IsaacNorris/p3-u3-w-hardware/p3-u3-w/p3-u3-w.csv

Reference | Qty | Value | DNP | Exclude from BOM | Exclude from Board | Footprint | Datasheet
C1,C2,C3,C5,C7,C9,C10,C12,C13,C14,C29,C32,C34,C35 | 14 | 100nF |  |  |  | Capacitor_SMD:C_0402_1005Metric
C4,C11,C33,C37,C38 | 5 | 4.7uF |  |  |  | Capacitor_SMD:C_0402_1005Metric
C6,C16,C36 | 3 | 1uF |  |  |  | Capacitor_SMD:C_0402_1005Metric
C8 | 1 | 100pF |  |  |  | Capacitor_SMD:C_0402_1005Metric
C15,C17,C26 | 3 | 2.2uF |  |  |  | Capacitor_SMD:C_0402_1005Metric
C18,C22,C25,C28 | 4 | 0.1uF |  |  |  | Capacitor_SMD:C_0402_1005Metric
C19,C21 | 2 | 2.2nF |  |  |  | Capacitor_SMD:C_0402_1005Metric
C20,C23,C24,C27,C39 | 5 | 10uF |  |  |  | Capacitor_SMD:C_0402_1005Metric
C30,C31 | 2 | 10pF |  |  |  | Capacitor_SMD:C_0402_1005Metric
C40 | 1 | 22uF |  |  |  | Capacitor_SMD:C_0402_1005Metric
C41 | 1 | 0.8pF |  |  |  | Capacitor_SMD:C_0402_1005Metric
C42 | 1 | 0.3pF |  |  |  | Capacitor_SMD:C_0402_1005Metric
CR1 | 1 | USBLC6-2SC6 |  |  |  | Package_TO_SOT_SMD:SOT-23-6 | https://www.st.com/resource/en/datasheet/usblc6-2.pdf
D1 | 1 | LED PWR Indicator |  |  |  | Diode_SMD:D_0603_1608Metric
J1 | 1 | SWD_pin |  |  |  | Connector_PinHeader_1.00mm:PinHeader_1x04_P1.00mm_Vertical
J2 | 1 | Display |  |  |  | Connector_PinHeader_2.54mm:PinHeader_1x04_P2.54mm_Vertical
J3 | 1 | SJ-3524-SMT |  |  |  | SJ_3524_SMT_TR:CUI_SJ-3524-SMT
J4 | 1 | 473092651 |  |  |  | 473092651:CONN12_47309-2651_MOL | https://www.molex.com/en-us/products/part-detail-pdf/473092651?display=pdf
J6 | 1 | 12401826E412A |  |  |  | 12401826E412A:12401826_AMP | 12401826E412A
J7 | 1 | Bat Conn |  |  |  | Connector_PinHeader_2.54mm:PinHeader_1x02_P2.54mm_Vertical
J8 | 1 | CONMHF1-SMD-G-T |  |  |  | CONMHF1-SMD-G-T:COAX3_CONMHF1-SMD-G-T_TEC | https://www.te.com/commerce/DocumentDelivery/DDEController?Action=srchrtrv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
L1 | 1 | 0.47uH |  |  |  | Inductor_SMD:L_0603_1608Metric
L2 | 1 | 2.7nH |  |  |  | Inductor_SMD:L_0603_1608Metric
L3 | 1 | 10uH |  |  |  | Inductor_SMD:L_0603_1608Metric
L4 | 1 | 10nH |  |  |  | Inductor_SMD:L_0603_1608Metric
R1 | 1 | 1k |  |  |  | Resistor_SMD:R_0402_1005Metric
R2,R3,R4,R11,R12,R13,R14,R15,R17,R18,R19,R20,R21 | 13 | 10k |  |  |  | Resistor_SMD:R_0402_1005Metric
R5,R6 | 2 | 470R |  |  |  | Resistor_SMD:R_0402_1005Metric
R7,R8,R9,R10 | 4 | 22R |  |  |  | Resistor_SMD:R_0402_1005Metric
R16,R28,R29 | 3 | 100k |  |  |  | Resistor_SMD:R_0402_1005Metric
R22,R23 | 2 | 5k1 |  |  |  | Resistor_SMD:R_0402_1005Metric
R24,R25 | 2 | 2k |  |  |  | Resistor_SMD:R_0402_1005Metric
R26,R27 | 2 | 220K |  |  |  | Resistor_SMD:R_0402_1005Metric
R30 | 1 | 560k |  |  |  | Resistor_SMD:R_0402_1005Metric
SW1,SW2,SW3,SW4,SW5,SW6,SW7 | 7 | SW_SPST |  |  |  | Button_Switch_SMD:Panasonic_EVQPUL_EVQPUC
TP1 | 1 | 5V |  |  |  | TestPoint:TestPoint_Pad_D1.0mm
TP2 | 1 | 3v3 |  |  |  | TestPoint:TestPoint_Pad_D1.0mm
U1 | 1 | LSM6DSM |  |  |  | Package_LGA:LGA-14_3x2.5mm_P0.5mm_LayoutBorder3x4y | https://www.st.com/resource/en/datasheet/lsm6dsm.pdf
U2 | 1 | PCM5102A |  |  |  | Package_SO:TSSOP-20_4.4x6.5mm_P0.65mm | https://www.ti.com/lit/ds/symlink/pcm5102a.pdf
U3 | 1 | STM32WB55CEUx |  |  |  | Package_DFN_QFN:QFN-48-1EP_7x7mm_P0.5mm_EP5.6x5.6mm | https://www.st.com/resource/en/datasheet/stm32wb55ce.pdf
U4 | 1 | LD39050PU33R |  |  |  | LD39050PU33R:DFN6_3X3_STM | https://www.st.com/resource/en/datasheet/ld39050.pdf
U5 | 1 | TPS63802DLAR |  |  |  | TPS63802DLAR:DLA0010A | https://www.ti.com/lit/gpn/tps63802
U6 | 1 | MCP73831T-2ACI/OT |  |  |  | MCP73831T_2ACI_OT:SOT-23-5_MC_MCH | MCP73831T-2ACI/OT
U7 | 1 | DLF162500LT-5028A1 |  |  |  | DLF162500LT:DLF-4_1P6X0P8 | DLF162500LT-5028A1
X1 | 1 | NX2016SA-32MHZ-EXS00A-CS06654 |  |  |  | NX2016SA-32MHZ-EXS00A-CS06654:NX2016SA_NDK | NX2016SA-32MHZ-EXS00A-CS06654
Y2 | 1 | 32k768 |  |  |  | Crystal:Crystal_SMD_3215-2Pin_3.2x1.5mm
