IsaacNorris/p3-u3-w-hardware/p3-u3-w/p3-u3-w.kicad_pcb

## KiCad design p3-u3-w/p3-u3-w.kicad_pcb (2026-11-10)

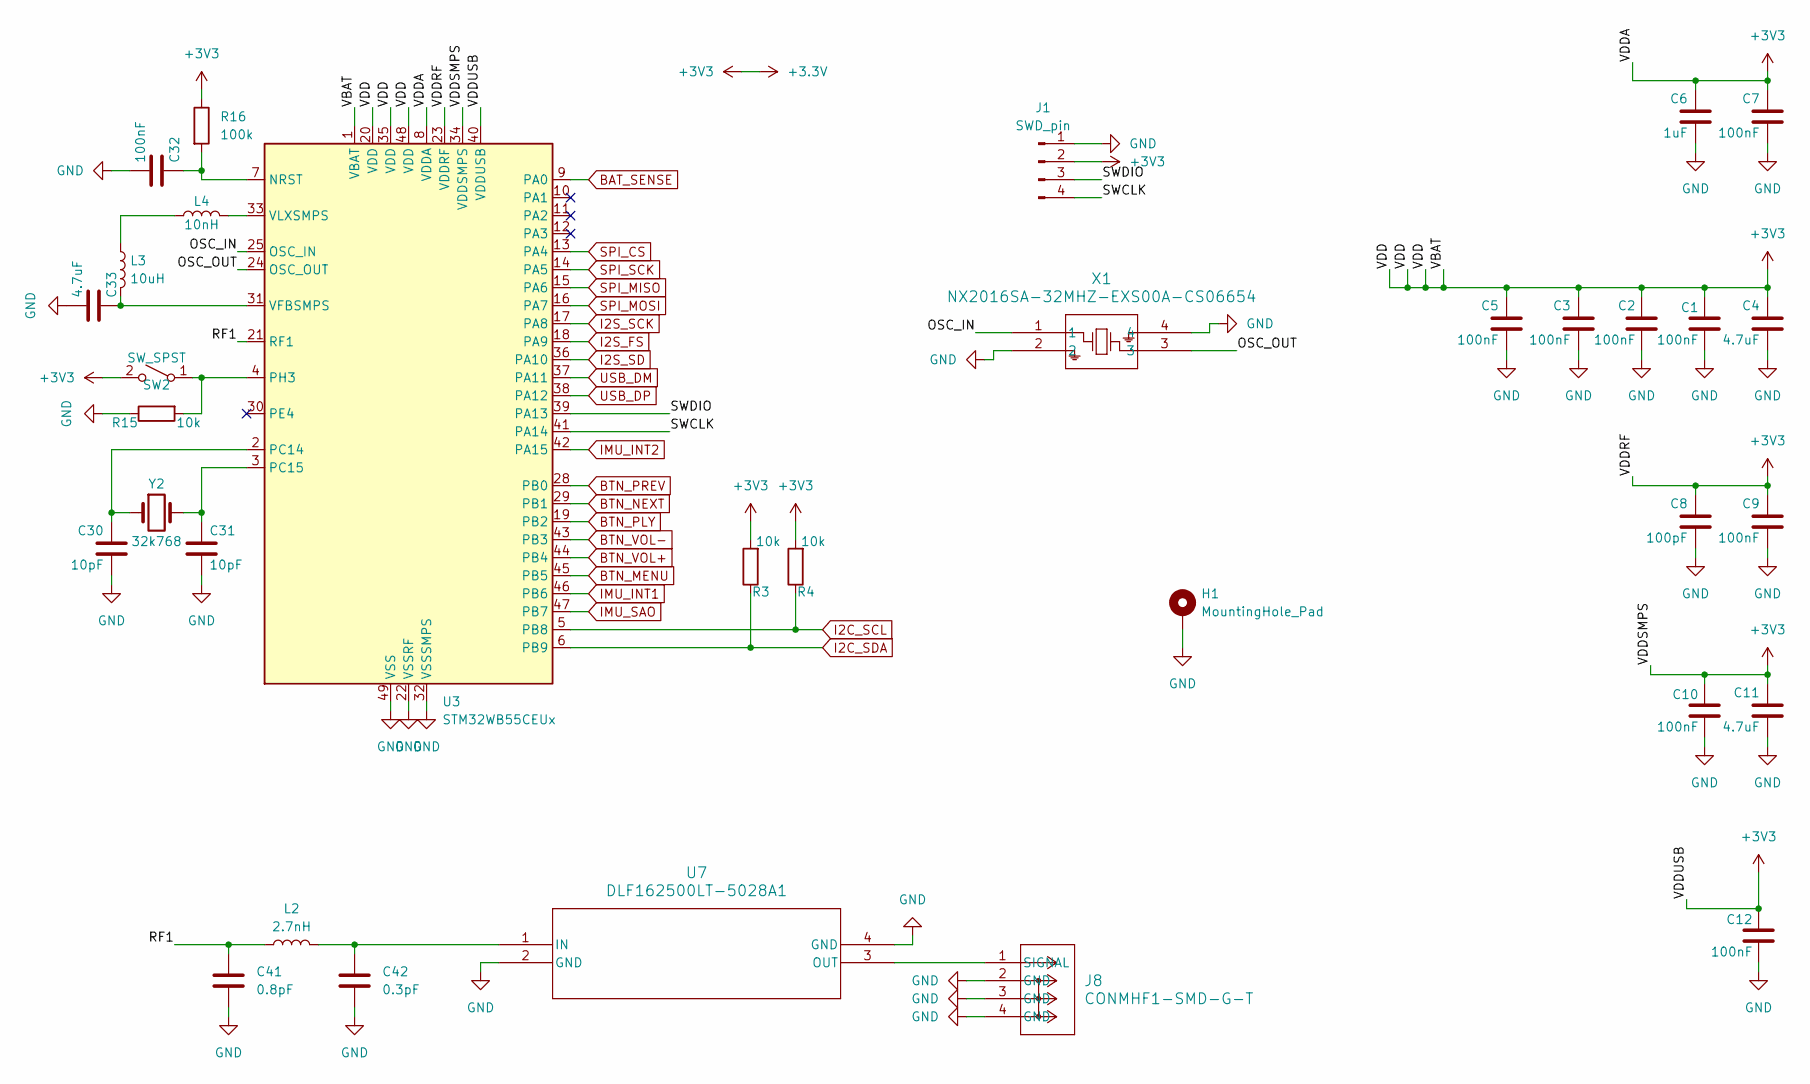
[picture p1: schematic MCU.kicad_sch]

Parts:
C1, C2, C3, C5, C7, C9, C10, C12, C32: 100nF; C_0402_1005Metric
C4, C11, C33: 4.7uF; C_0402_1005Metric
C6: 1uF; C_0402_1005Metric
C8: 100pF; C_0402_1005Metric
C30, C31: 10pF; C_0402_1005Metric
C41: 0.8pF; C_0402_1005Metric
C42: 0.3pF; C_0402_1005Metric
H1: MountingHole_Pad; MountingHole_2.2mm_M2_Pad
J1: SWD_pin; PinHeader_1x04_P1.00mm_Vertical
J8: CONMHF1-SMD-G-T; COAX3_CONMHF1-SMD-G-T_TEC
L2: 2.7nH; L_0603_1608Metric
L3: 10uH; L_0603_1608Metric
L4: 10nH; L_0603_1608Metric
R3, R4, R15: 10k; R_0402_1005Metric
R16: 100k; R_0402_1005Metric
SW2: SW_SPST; Panasonic_EVQPUL_EVQPUC
U3: STM32WB55CEUx; QFN-48-1EP_7x7mm_P0.5mm_EP5.6x5.6mm
U7: DLF162500LT-5028A1; DLF-4_1P6X0P8
X1: NX2016SA-32MHZ-EXS00A-CS06654; NX2016SA_NDK
Y2: 32k768; Crystal_SMD_3215-2Pin_3.2x1.5mm

Connections:
+3.3V: C1.2, C2.2, C3.2, C4.2, C5.2, C6.2, C7.2, C8.2, C9.2, C10.2, C11.2, C12.2, J1.2, R3.2, R4.2, R16.1, SW2.2 (B), U3.1 (VBAT), U3.8 (VDDA), U3.20 (VDD), U3.23 (VDDRF), U3.34 (VDDSMPS), U3.35 (VDD), U3.40 (VDDUSB), U3.48 (VDD); also elsewhere on the board
/MCU/OSC_IN: U3.25 (OSC_IN), X1.1
/MCU/OSC_OUT: U3.24 (OSC_OUT), X1.3
/MCU/RF1: C41.1, L2.1, U3.21 (RF1)
/MCU/SWCLK: J1.4, U3.41 (PA14)
/MCU/SWDIO: J1.3, U3.39 (PA13)
BAT_SENSE: U3.9 (PA0); also elsewhere on the board
BTN_MENU: U3.45 (PB5); also elsewhere on the board
BTN_NEXT: U3.29 (PB1); also elsewhere on the board
BTN_PLY: U3.19 (PB2); also elsewhere on the board
BTN_PREV: U3.28 (PB0); also elsewhere on the board
BTN_VOL+: U3.44 (PB4); also elsewhere on the board
BTN_VOL-: U3.43 (PB3); also elsewhere on the board
GND: C1.1, C2.1, C3.1, C4.1, C5.1, C6.1, C7.1, C8.1, C9.1, C10.1, C11.1, C12.1, C30.1, C31.1, C32.1, C33.1, C41.2, C42.2, H1.1 (1_1), J1.1, J8.2 (GND), J8.3 (GND), J8.4 (GND), R15.1, U3.22 (VSSRF), U3.32 (VSSSMPS), U3.49 (VSS), U7.2 (GND), U7.4 (GND), X1.2, X1.4; also elsewhere on the board
I2C_SCL: R4.1, U3.5 (PB8); also elsewhere on the board
I2C_SDA: R3.1, U3.6 (PB9); also elsewhere on the board
I2S_FS: U3.18 (PA9); also elsewhere on the board
I2S_SCK: U3.17 (PA8); also elsewhere on the board
I2S_SD: U3.36 (PA10); also elsewhere on the board
IMU_INT1: U3.46 (PB6); also elsewhere on the board
IMU_INT2: U3.42 (PA15); also elsewhere on the board
IMU_SAO: U3.47 (PB7); also elsewhere on the board
unnamed: J8.1 (SIGNAL), U7.3 (OUT)
unnamed: L3.1, L4.1
unnamed: R15.2, SW2.1 (A), U3.4 (PH3)
unnamed: C32.2, R16.2, U3.7 (NRST)
unnamed: C30.2, U3.2 (PC14), Y2.1
unnamed: C31.2, U3.3 (PC15), Y2.2
unnamed: C33.2, L3.2, U3.31 (VFBSMPS)
unnamed: L4.2, U3.33 (VLXSMPS)
unnamed: C42.1, L2.2, U7.1 (IN)
SPI_CS: U3.13 (PA4); also elsewhere on the board
SPI_MISO: U3.15 (PA6); also elsewhere on the board
SPI_MOSI: U3.16 (PA7); also elsewhere on the board
SPI_SCK: U3.14 (PA5); also elsewhere on the board
USB_D+: U3.38 (PA12); also elsewhere on the board
USB_D-: U3.37 (PA11); also elsewhere on the board

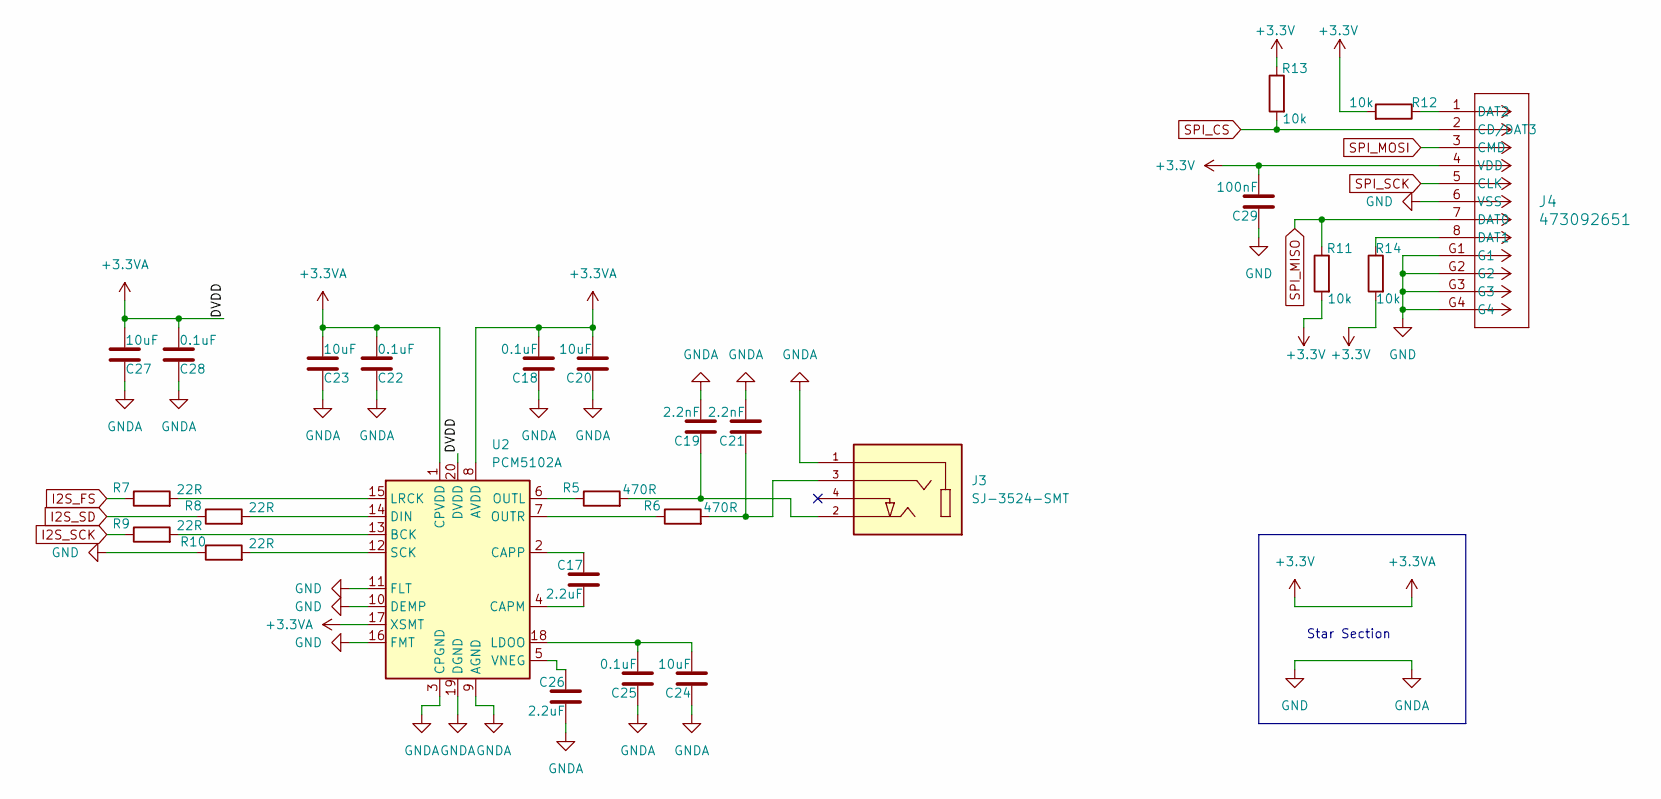
[picture p2: schematic SD_DAC.kicad_sch]

Parts:
C17, C26: 2.2uF; C_0402_1005Metric
C18, C22, C25, C28: 0.1uF; C_0402_1005Metric
C19, C21: 2.2nF; C_0402_1005Metric
C20, C23, C24, C27: 10uF; C_0402_1005Metric
C29: 100nF; C_0402_1005Metric
J3: SJ-3524-SMT; CUI_SJ-3524-SMT; PARTREV 1.03
J4: 473092651; CONN12_47309-2651_MOL
R5, R6: 470R; R_0402_1005Metric
R7, R8, R9, R10: 22R; R_0402_1005Metric
R11, R12, R13, R14: 10k; R_0402_1005Metric
U2: PCM5102A; TSSOP-20_4.4x6.5mm_P0.65mm

Connections:
+3.3V: C18.2, C20.2, C22.2, C23.2, C27.2, C28.2, C29.2, J4.4 (VDD), R11.2, R12.2, R13.1, R14.2, U2.1 (CPVDD), U2.8 (AVDD), U2.17 (XSMT), U2.20 (DVDD); also elsewhere on the board
GND: C18.1, C19.2, C20.1, C21.2, C22.1, C23.1, C24.1, C25.1, C26.2, C27.1, C28.1, C29.1, J3.1, J4.6 (VSS), J4.G1, J4.G2, J4.G3, J4.G4, R10.1, U2.3 (CPGND), U2.9 (AGND), U2.10 (DEMP), U2.11 (FLT), U2.16 (FMT), U2.19 (DGND); also elsewhere on the board
I2S_FS: R7.1; also elsewhere on the board
I2S_SCK: R9.1; also elsewhere on the board
I2S_SD: R8.1; also elsewhere on the board
unnamed: C19.1, J3.2, R5.2
unnamed: C21.1, J3.3, R6.2
unnamed: J4.8 (DAT1), R14.1
unnamed: J4.1 (DAT2), R12.1
unnamed: R9.2, U2.13 (BCK)
unnamed: C17.2, U2.4 (CAPM)
unnamed: C17.1, U2.2 (CAPP)
unnamed: R8.2, U2.14 (DIN)
unnamed: C24.2, C25.2, U2.18 (LDOO)
unnamed: R7.2, U2.15 (LRCK)
unnamed: R5.1, U2.6 (OUTL)
unnamed: R6.1, U2.7 (OUTR)
unnamed: R10.2, U2.12 (SCK)
unnamed: C26.1, U2.5 (VNEG)
SPI_CS: J4.2 (CD/DAT3), R13.2; also elsewhere on the board
SPI_MISO: J4.7 (DAT0), R11.1; also elsewhere on the board
SPI_MOSI: J4.3 (CMD); also elsewhere on the board
SPI_SCK: J4.5 (CLK); also elsewhere on the board

Notes on the sheet:
Star Section

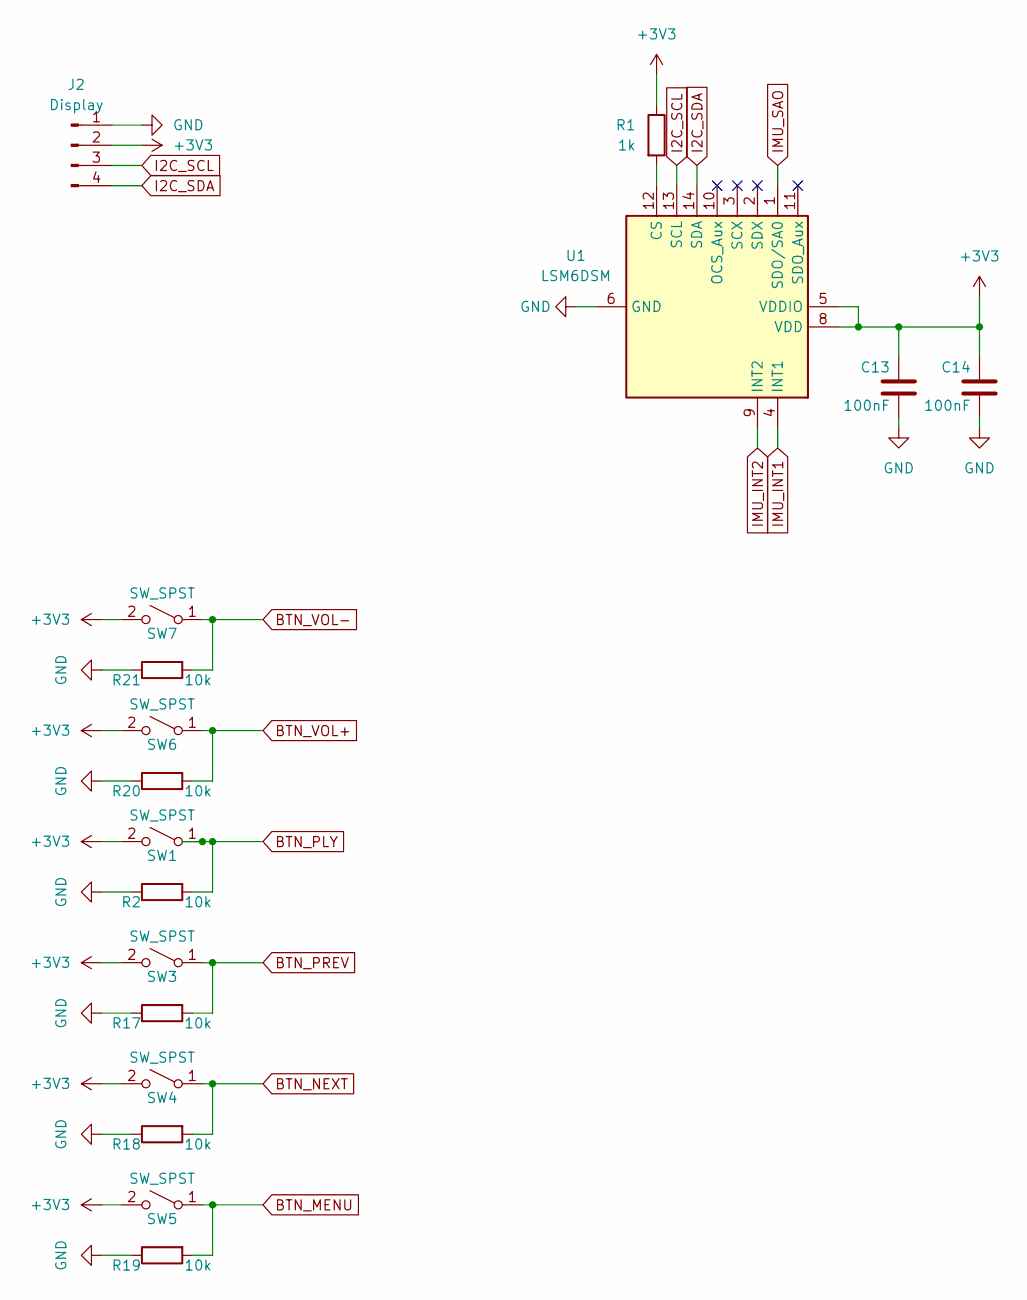
[picture p3: schematic Display_IMU.kicad_sch]

Parts:
C13, C14: 100nF; C_0402_1005Metric
J2: Display; PinHeader_1x04_P2.54mm_Vertical
R1: 1k; R_0402_1005Metric
R2, R17, R18, R19, R20, R21: 10k; R_0402_1005Metric
SW1, SW3, SW4, SW5, SW6, SW7: SW_SPST; Panasonic_EVQPUL_EVQPUC
U1: LSM6DSM; LGA-14_3x2.5mm_P0.5mm_LayoutBorder3x4y

Connections:
+3.3V: C13.2, C14.2, J2.2, R1.1, SW1.2 (B), SW3.2 (B), SW4.2 (B), SW5.2 (B), SW6.2 (B), SW7.2 (B), U1.5 (VDDIO), U1.8 (VDD); also elsewhere on the board
BTN_MENU: R19.2, SW5.1 (A); also elsewhere on the board
BTN_NEXT: R18.2, SW4.1 (A); also elsewhere on the board
BTN_PLY: R2.2, SW1.1 (A); also elsewhere on the board
BTN_PREV: R17.2, SW3.1 (A); also elsewhere on the board
BTN_VOL+: R20.2, SW6.1 (A); also elsewhere on the board
BTN_VOL-: R21.2, SW7.1 (A); also elsewhere on the board
GND: C13.1, C14.1, J2.1, R2.1, R17.1, R18.1, R19.1, R20.1, R21.1, U1.6 (GND), U1.7 (GND); also elsewhere on the board
I2C_SCL: J2.3, U1.13 (SCL); also elsewhere on the board
I2C_SDA: J2.4, U1.14 (SDA); also elsewhere on the board
IMU_INT1: U1.4 (INT1); also elsewhere on the board
IMU_INT2: U1.9 (INT2); also elsewhere on the board
IMU_SAO: U1.1 (SDO/SA0); also elsewhere on the board
unnamed: R1.2, U1.12 (CS)

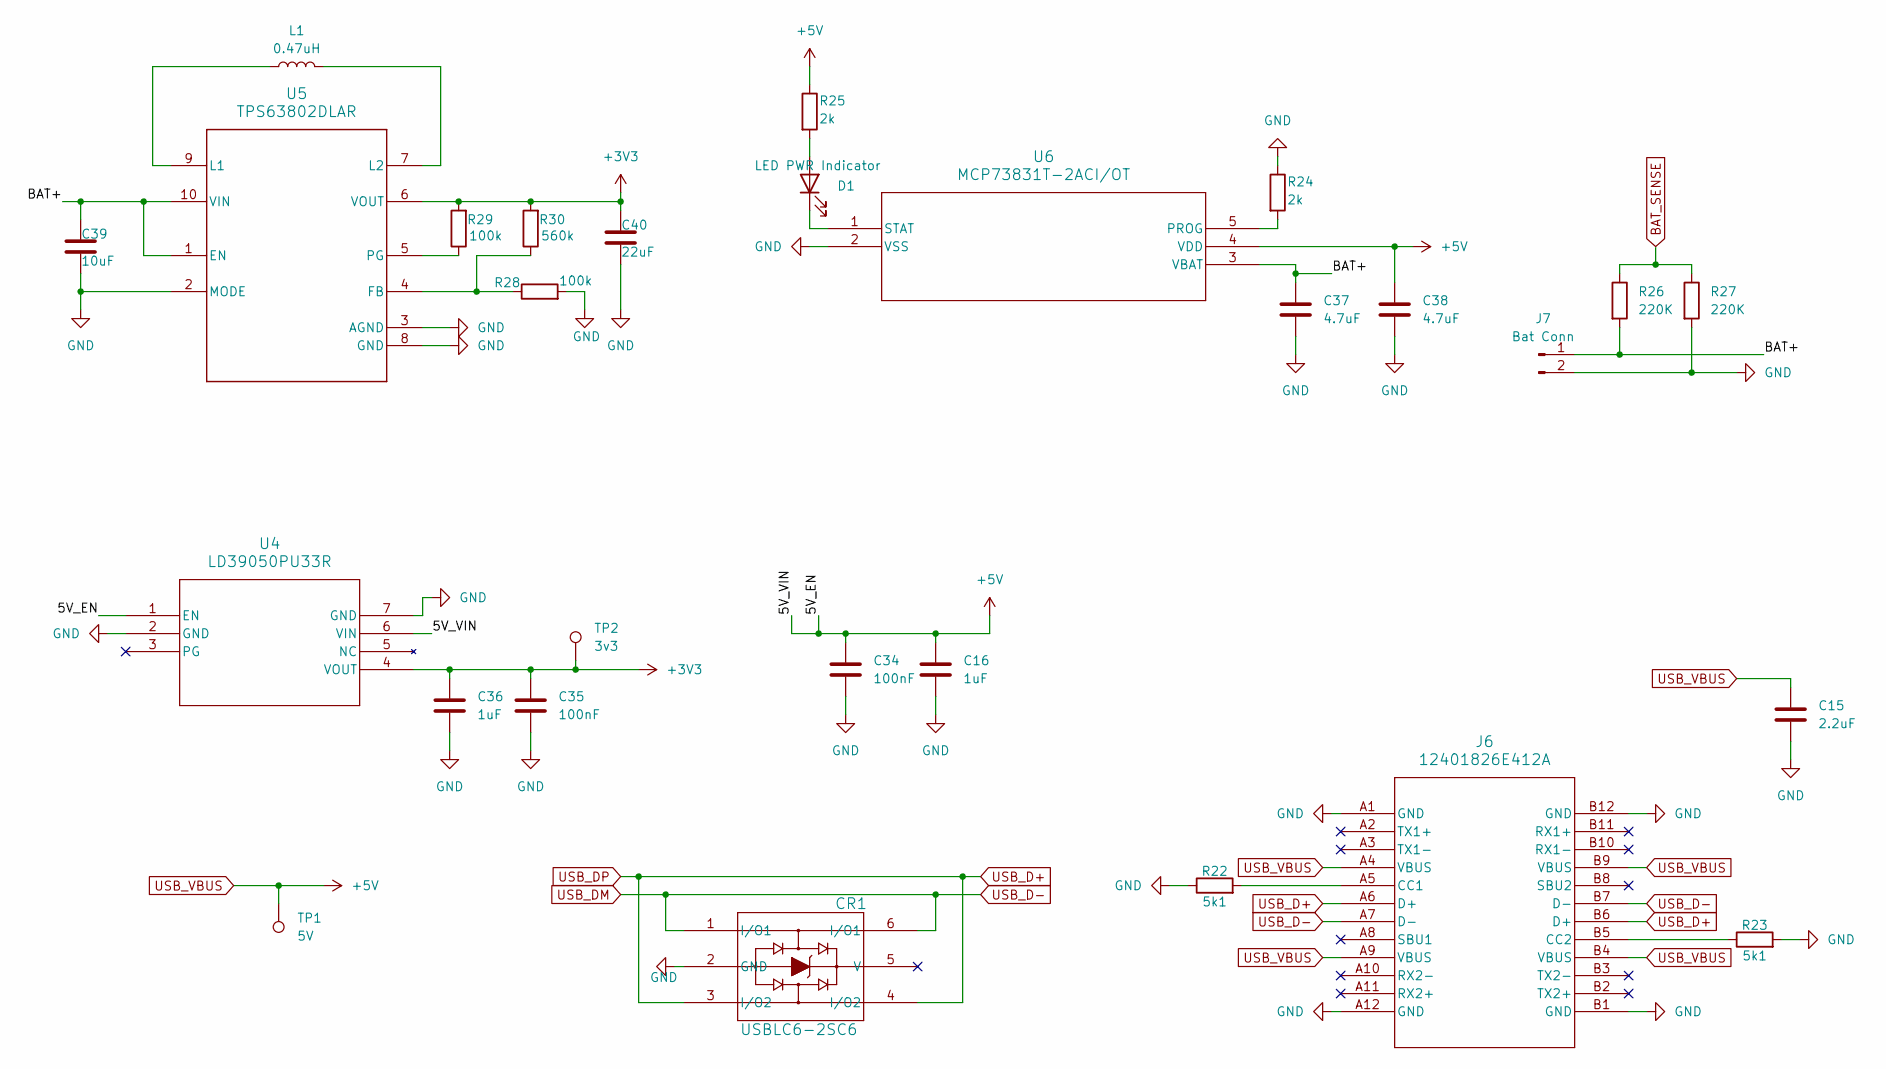
[picture p4: schematic USB_PWR.kicad_sch]

Parts:
C15: 2.2uF; C_0402_1005Metric
C16, C36: 1uF; C_0402_1005Metric
C34, C35: 100nF; C_0402_1005Metric
C37, C38: 4.7uF; C_0402_1005Metric
C39: 10uF; C_0402_1005Metric
C40: 22uF; C_0402_1005Metric
CR1: USBLC6-2SC6; SOT-23-6
D1: LED PWR Indicator; D_0603_1608Metric
J6: 12401826E412A; 12401826_AMP
J7: Bat Conn; PinHeader_1x02_P2.54mm_Vertical
L1: 0.47uH; L_0603_1608Metric
R22, R23: 5k1; R_0402_1005Metric
R24, R25: 2k; R_0402_1005Metric
R26, R27: 220K; R_0402_1005Metric
R28, R29: 100k; R_0402_1005Metric
R30: 560k; R_0402_1005Metric
TP1: 5V; TestPoint_Pad_D1.0mm
TP2: 3v3; TestPoint_Pad_D1.0mm
U4: LD39050PU33R; DFN6_3X3_STM
U5: TPS63802DLAR; DLA0010A
U6: MCP73831T-2ACI/OT; SOT-23-5_MC_MCH

Connections:
+3.3V: C35.1, C36.1, C40.1, R29.2, R30.2, TP2.1 (1_1), U4.4 (VOUT), U5.6 (VOUT); also elsewhere on the board
/USB_PWR/BAT+: C37.1, C39.1, J7.1, R26.2, U5.1 (EN), U5.10 (VIN), U6.3 (VBAT)
BAT_SENSE: R26.1, R27.1; also elsewhere on the board
GND: C15.2, C16.2, C34.2, C35.2, C36.2, C37.2, C38.2, C39.2, C40.2, CR1.2 (GND), J6.A1 (GND), J6.A12 (GND), J6.B1 (GND), J6.B12 (GND), J7.2, R22.1, R23.2, R24.1, R27.2, R28.2, U4.2 (GND), U4.7 (GND), U5.2 (MODE), U5.3 (AGND), U5.8 (GND), U6.2 (VSS); also elsewhere on the board
unnamed: D1.2 (A), R25.2
unnamed: D1.1 (K), U6.1 (STAT)
unnamed: J6.A5 (CC1), R22.2
unnamed: J6.B5 (CC2), R23.1
unnamed: R28.1, R30.1, U5.4 (FB)
unnamed: L1.1, U5.9 (L1)
unnamed: L1.2, U5.7 (L2)
unnamed: R29.1, U5.5 (PG)
unnamed: R24.2, U6.5 (PROG)
USB_D+: CR1.3 (I/O2), CR1.4 (I/O2), J6.A6 (D+), J6.B6 (D+); also elsewhere on the board
USB_D-: CR1.1 (I/O1), CR1.6 (I/O1), J6.A7 (D-), J6.B7 (D-); also elsewhere on the board
USB_VBUS: C15.1, C16.1, C34.1, C38.1, J6.A4 (VBUS), J6.A9 (VBUS), J6.B4 (VBUS), J6.B9 (VBUS), R25.1, TP1.1 (1_1), U4.1 (EN), U4.6 (VIN), U6.4 (VDD)

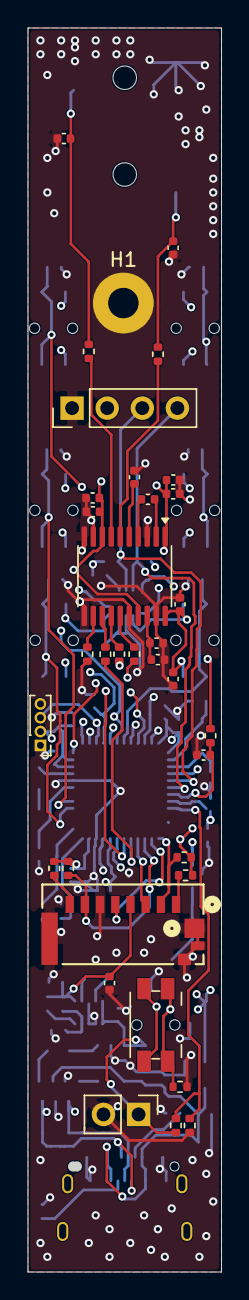
[picture p5: board p3-u3-w.kicad_pcb from above]

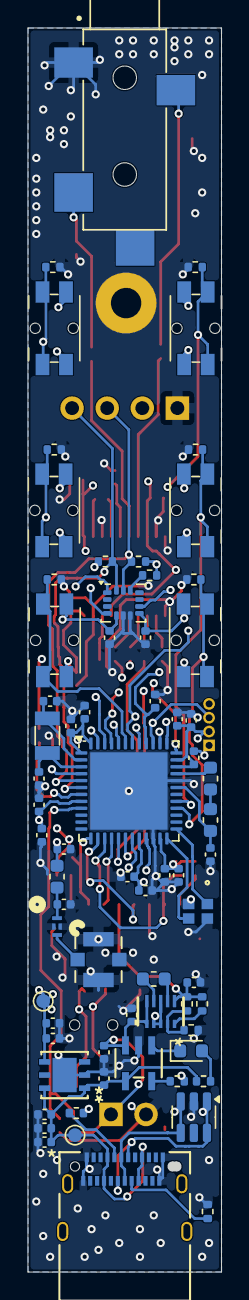
[picture p6: board p3-u3-w.kicad_pcb from below]

Board: 6 copper layers, 14.0 x 90.0 mm, 104 parts (69 on the bottom side), 63 nets.
