IsaacNorris/p3-u3-w-hardware/(commit log)

2026-08-17 started out the mcu decoupling.
    [MCU.kicad_sch, p3-u3-w.kicad_pcb, p3-u3-w.kicad_sch]
2026-08-18 added in some buttons and pinout.
    [MCU.kicad_sch]
2026-08-18 added in i2C pullups, added in display
    [Display_IMU.kicad_sch, MCU.kicad_sch, p3-u3-w.kicad_sch]
2026-08-19 added in power side and mostly finished schematics :)
    [Display_IMU.kicad_sch, MCU.kicad_sch, SD_DAC.kicad_sch, USB_PWR.kicad_sch, p3-u3-w.kicad_sch]
2026-08-19 finished schematics, started routing and layout.
    [Display_IMU.kicad_sch, MCU.kicad_sch, SD_DAC.kicad_sch, USB_PWR.kicad_sch, p3-u3-w.kicad_pcb]
2026-08-20 changed some routing
    [Display_IMU.kicad_sch, MCU.kicad_sch, SD_DAC.kicad_sch, USB_PWR.kicad_sch, p3-u3-w.kicad_pcb]
2026-08-20 added in some more routing.
    [Display_IMU.kicad_sch, MCU.kicad_sch, SD_DAC.kicad_sch, p3-u3-w.kicad_pcb]
2026-08-21 did some more routing.
    [MCU.kicad_sch, p3-u3-w.kicad_pcb]
2026-08-21 finished routing need to pass drc
    [SD_DAC.kicad_sch, p3-u3-w.kicad_pcb]
2026-08-22 did drc mostly finished drc, need to remove silkscreen designators aswell.
    [p3-u3-w.kicad_pcb]
2026-08-22 passed drc, removed silkscreen, ready for review.
    [p3-u3-w.kicad_pcb]
2026-10-26 finished the pcb, added in BOM
2026-11-10 added in gerber and models.
2026-11-10 added in mounting hole.
